hwiguna/HariFun_207_UnoMiniLECube/KiCad/UnoMiniCube/UnoMiniCube.kicad_pcb

## KiCad design KiCad/UnoMiniCube/UnoMiniCube.kicad_pcb (2022-06-09)

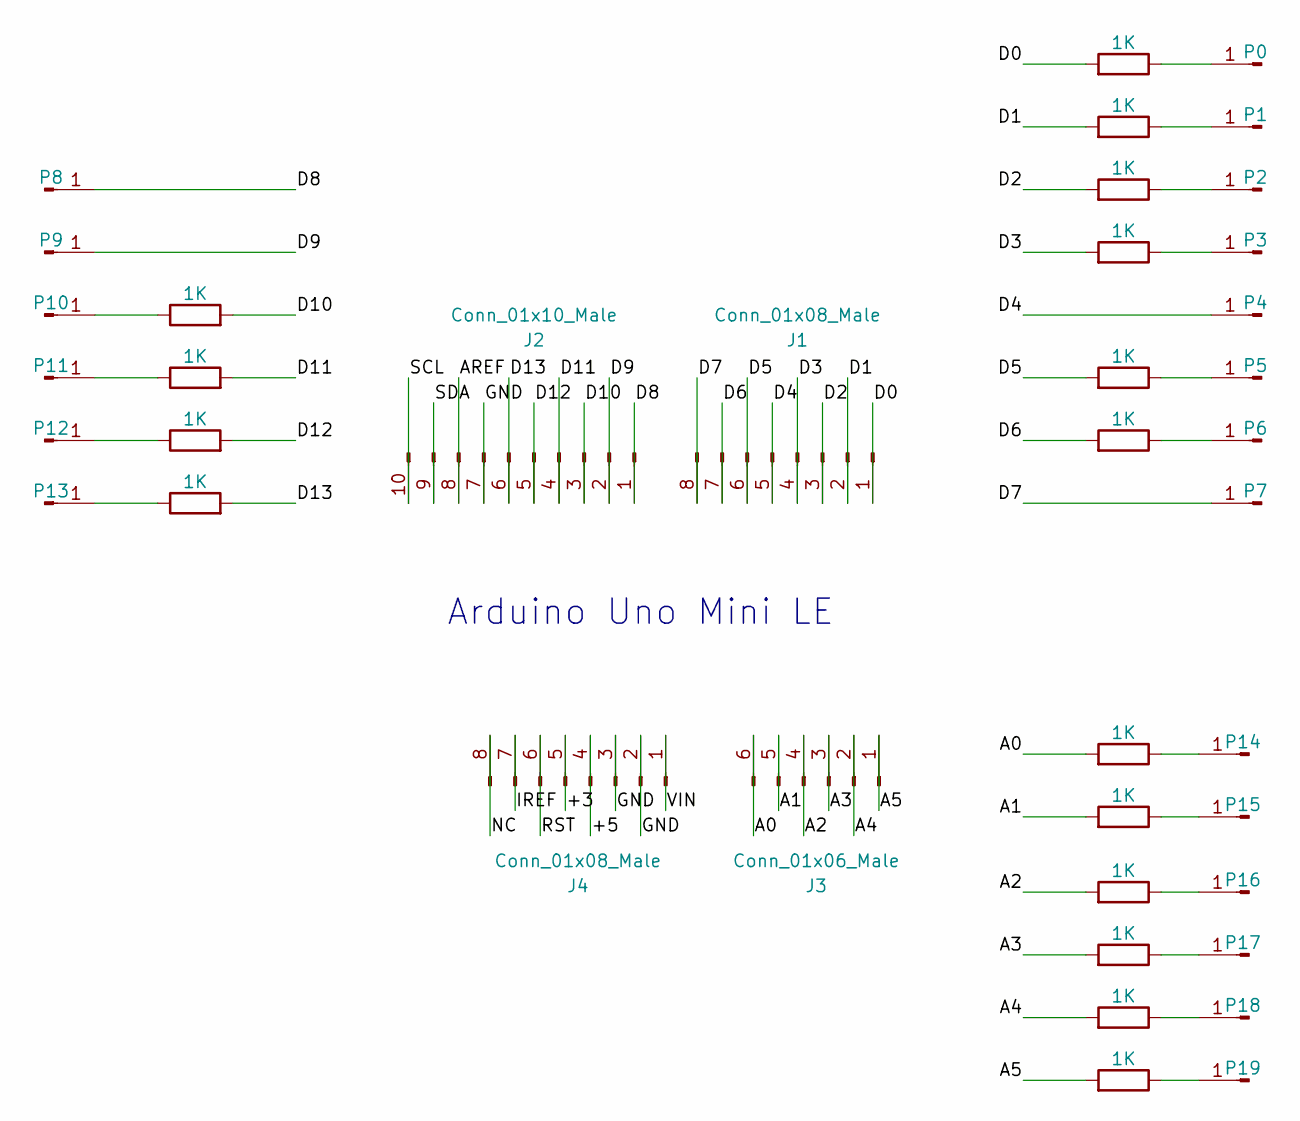
[picture p1: schematic UnoMiniCube.kicad_sch]

Parts:
J1, J4: Conn_01x08_Male; PinHeader_1x08_P1.27mm_Vertical
J2: Conn_01x10_Male; PinHeader_1x10_P1.27mm_Vertical
J3: Conn_01x06_Male; PinHeader_1x06_P1.27mm_Vertical
P0, P1, P2, P3, P4, P5, P6, P7, P8, P9, P10, P11, P12, P13, P14, P15, P16, P17, P18, P19: Conn_01x01_Male; PinHeader_1x01_P1.27mm_Vertical_Hari
R1, R2, R3, R4, R5, R6, R7, R11, R12, R13, R14, R15, R16, R17, R18, R19: 1K; R_0805_2012Metric_Pad1.20x1.40mm_HandSolder

Connections:
/+3: J4.5
/+5: J4.4
/A0: J3.6, R19.2
/A1: J3.5, R18.2
/A2: J3.4, R17.2
/A3: J3.3, R5.2
/A4: J3.2, R16.2
/A5: J3.1, R15.2
/AREF: J2.8
/D0: J1.1, R1.2
/D1: J1.2, R2.2
/D2: J1.3, R3.2
/D3: J1.4, R4.2
/D4: J1.5, P4.1
/D5: J1.6, R6.2
/D6: J1.7, R7.2
/D7: J1.8, P7.1
/D8: J2.1, P8.1
/D9: J2.2, P9.1
/D10: J2.3, R11.2
/D11: J2.4, R12.2
/D12: J2.5, R13.2
/D13: J2.6, R14.2
/GND: J2.7, J4.2, J4.3
/IREF: J4.7
/NC: J4.8
/RST: J4.6
/SCL: J2.10
/SDA: J2.9
/VIN: J4.1
unnamed: P0.1, R1.1
unnamed: P1.1, R2.1
unnamed: P2.1, R3.1
unnamed: P3.1, R4.1
unnamed: P5.1, R6.1
unnamed: P6.1, R7.1
unnamed: P10.1, R11.1
unnamed: P11.1, R12.1
unnamed: P12.1, R13.1
unnamed: P13.1, R14.1
unnamed: P14.1, R19.1
unnamed: P15.1, R18.1
unnamed: P16.1, R17.1
unnamed: P17.1, R5.1
unnamed: P18.1, R16.1
unnamed: P19.1, R15.1

Notes on the sheet:
Arduino Uno Mini LE

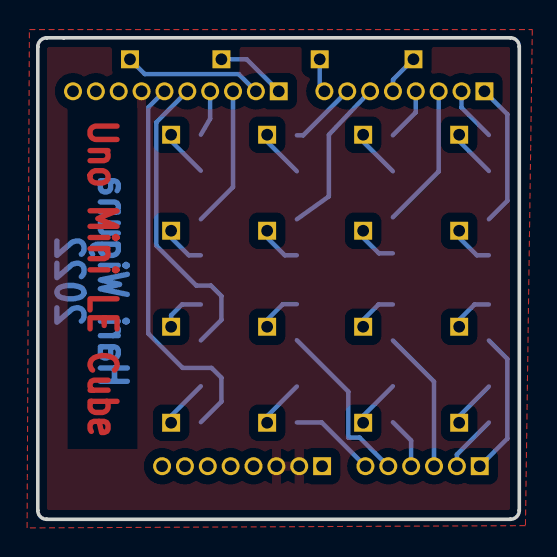
[picture p2: board UnoMiniCube.kicad_pcb from above]

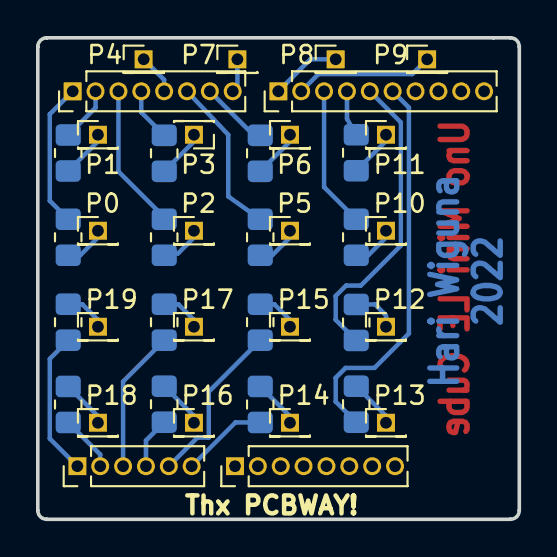
[picture p3: board UnoMiniCube.kicad_pcb from below]

Board: 2 copper layers, 26.8 x 26.8 mm, 40 parts (40 on the bottom side), 37 nets.
