hwiguna/HariFun_207_UnoMiniLECube/Sketches/FirstFourLEDs/FirstFourLEDs.ino

byte seq[] = {0, 1, 2, 3, 2, 1};

// the setup function runs once when you press reset or power the board
void setup() {
  // initialize digital pin LED_BUILTIN as an output.
  pinMode(2, OUTPUT);
  pinMode(3, OUTPUT);
  pinMode(4, OUTPUT);
  pinMode(5, OUTPUT);
}

// the loop function runs over and over again forever
void loop() {
  for (int d = 250; d > -500; d -= 50) {
    for (byte i = 0; i < sizeof(seq); i++) {
      byte pin = 2 + seq[i];
      digitalWrite(pin, HIGH);   // turn the LED on (HIGH is the voltage level)
      delay(max(d, 50));
      digitalWrite(pin, LOW);
    }
  }
}
