hwiguna/HariFun_207_UnoMiniLECube/(commit log)

2022-05-30 Major code cleanup. Still have to fix plane vs orientation.
    [UnoCube.ino]
2022-06-09 Commit gerbers
    [UnoMiniCube-B_Cu.gbr, UnoMiniCube-B_Mask.gbr, UnoMiniCube-B_Paste.gbr, UnoMiniCube-B_Silkscreen.gbr, UnoMiniCube-Edge_Cuts.gbr, UnoMiniCube-F_Cu.gbr, UnoMiniCube-F_Mask.gbr, UnoMiniCube-F_Paste.gbr]
